agausmann/HWLife/README.md

# HWLife

Experiments in implementing Conway's Game of Life using tiled hardware.
