agausmann/HWLife/(list of files, cad)

Other CAD files:
rev1/life-cell/front-cover/front-cover.scad
rev1/modular-backplane/assembly/backplane-connector-jig.scad
rev1/modular-backplane/backplane-link/common.scad
rev1/modular-backplane/backplane-link/h-link.scad
rev1/modular-backplane/backplane-link/demo.scad
rev1/modular-backplane/backplane-link/x-link.scad
