agausmann/HWLife/rev2/life-cell-rev2/life-cell-rev2.kicad_pcb

## KiCad design rev2/life-cell-rev2/life-cell-rev2.kicad_pcb (2024-03-23, an earlier design)

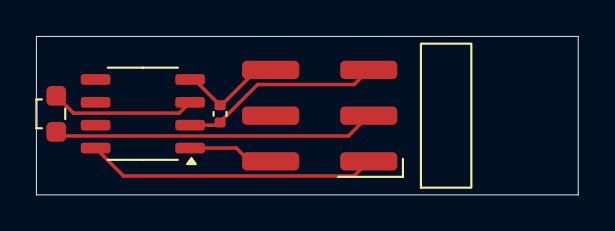
[picture p3: board life-cell-rev2.kicad_pcb from above]

Board: 2 copper layers, 30.1 x 8.8 mm, 4 parts (0 on the bottom side), 6 nets.

Parts:
C1: 100nF; C_0402_1005Metric
D1: LED; LiteOn_LTST-S270KxKT
J1: Backplane; Conn_HCTL_PZ254-2-03-WS
U1: CH32V003J4M6; SOP-8_3.9x4.9mm_P1.27mm

Connections:
/DIM: D1.1 (K), J1.3
/LED: D1.2 (A), U1.3 (PA2)
/RX: J1.2, U1.1 (PD6/PA1)
/TX/SWIO: J1.1, U1.8 (PD1/PD4/PD5)
VDD: C1.1, J1.6, U1.4 (VDD)
VSS: C1.2, J1.5, U1.2 (VSS)
