agausmann/HWLife/rev2/backplane-rev2/backplane-rev2.kicad_pcb

## KiCad design rev2/backplane-rev2/backplane-rev2.kicad_pcb (2024-03-23, an earlier design)

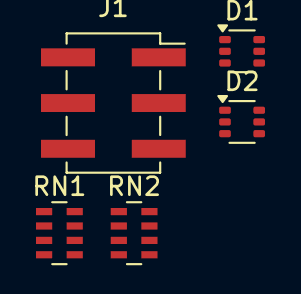
[picture p4: board backplane-rev2.kicad_pcb from above]

Board: 2 copper layers, 5 parts (0 on the bottom side), 9 nets, no tracks yet.

Parts:
D1, D2: BAT54ADW; SOT-363_SC-70-6
J1: Module; PinSocket_2x03_P2.54mm_Vertical_SMD
RN1, RN2: 10K; R_Array_Concave_4x0603

Connections:
/A1/D: D1.3 (A), D1.6 (A), D2.3 (A), D2.6 (A), J1.3
unnamed: D1.1 (K), RN1.5 (R4.2)
unnamed: D1.2 (K), RN1.6 (R3.2)
unnamed: D1.4 (K), RN1.7 (R2.2)
unnamed: D1.5 (K), RN1.8 (R1.2)
unnamed: D2.1 (K), RN2.5 (R4.2)
unnamed: D2.2 (K), RN2.6 (R3.2)
unnamed: D2.4 (K), RN2.7 (R2.2)
unnamed: D2.5 (K), RN2.8 (R1.2)
