agausmann/HWLife/rev1/modular-backplane/single-cell/single-cell.kicad_pcb

## KiCad design rev1/modular-backplane/single-cell/single-cell.kicad_pcb (2023-02-07, an earlier design)

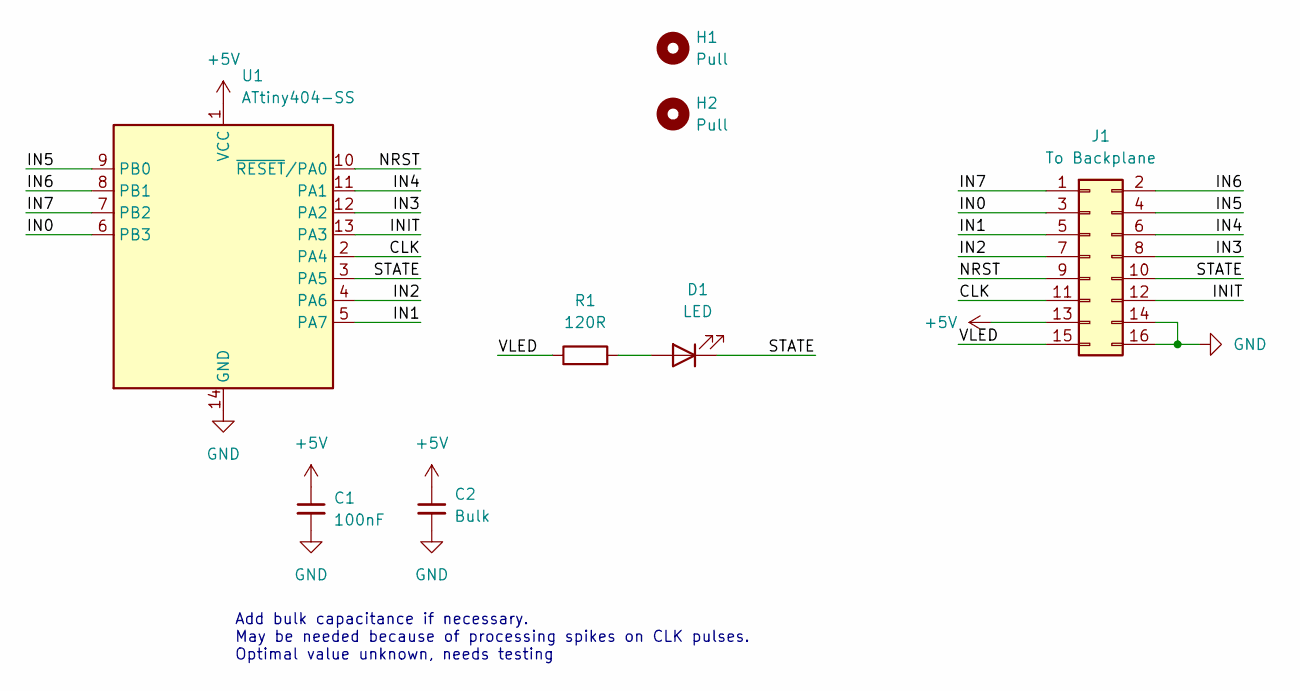
[picture p5: schematic single-cell.kicad_sch]

Parts:
C1: 100nF; C_0603_1608Metric_Pad1.08x0.95mm_HandSolder; DigiKey 2997-MA0603XR104M160TR-ND
C2: Bulk; C_0603_1608Metric_Pad1.08x0.95mm_HandSolder
D1: LED; LED_0603_1608Metric_Pad1.05x0.95mm_HandSolder; DigiKey 3147-B1911UYG-20D000114U1930CT-ND
H1, H2: Pull; Hole_Cell
J1: To Backplane; XKB_X1321FVS_02x08_P1.27mm_Vertical
R1: 120R; R_0603_1608Metric_Pad0.98x0.95mm_HandSolder; DigiKey 2571-RM06F1200CTTR-ND
U1: ATtiny404-SS; SOIC-14_3.9x8.7mm_P1.27mm; DigiKey ATTINY404-SSN-ND

Connections:
+5V: C1.1, C2.1, J1.13, U1.1 (VCC)
/CLK: J1.11, U1.2 (PA4)
/IN0: J1.3, U1.6 (PB3)
/IN1: J1.5, U1.5 (PA7)
/IN2: J1.7, U1.4 (PA6)
/IN3: J1.8, U1.12 (PA2)
/IN4: J1.6, U1.11 (PA1)
/IN5: J1.4, U1.9 (PB0)
/IN6: J1.2, U1.8 (PB1)
/IN7: J1.1, U1.7 (PB2)
/INIT: J1.12, U1.13 (PA3)
/NRST: J1.9, U1.10 (~RESET/PA0)
/STATE: D1.1 (K), J1.10, U1.3 (PA5)
/VLED: J1.15, R1.1
GND: C1.2, C2.2, J1.14, J1.16, U1.14 (GND)
unnamed: D1.2 (A), R1.2

Notes on the sheet:
Add bulk capacitance if necessary. May be needed because of processing spikes on CLK pulses. Optimal value unknown, needs testing

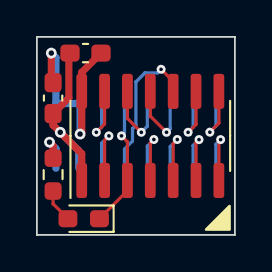
[picture p6: board single-cell.kicad_pcb from above]

Board: 2 copper layers, 11.0 x 11.0 mm, 8 parts (1 on the bottom side), 16 nets.
