agausmann/HWLife/rev1/modular-backplane/backplane/backplane.kicad_pcb

## KiCad design rev1/modular-backplane/backplane/backplane.kicad_pcb (2023-02-07, an earlier design)

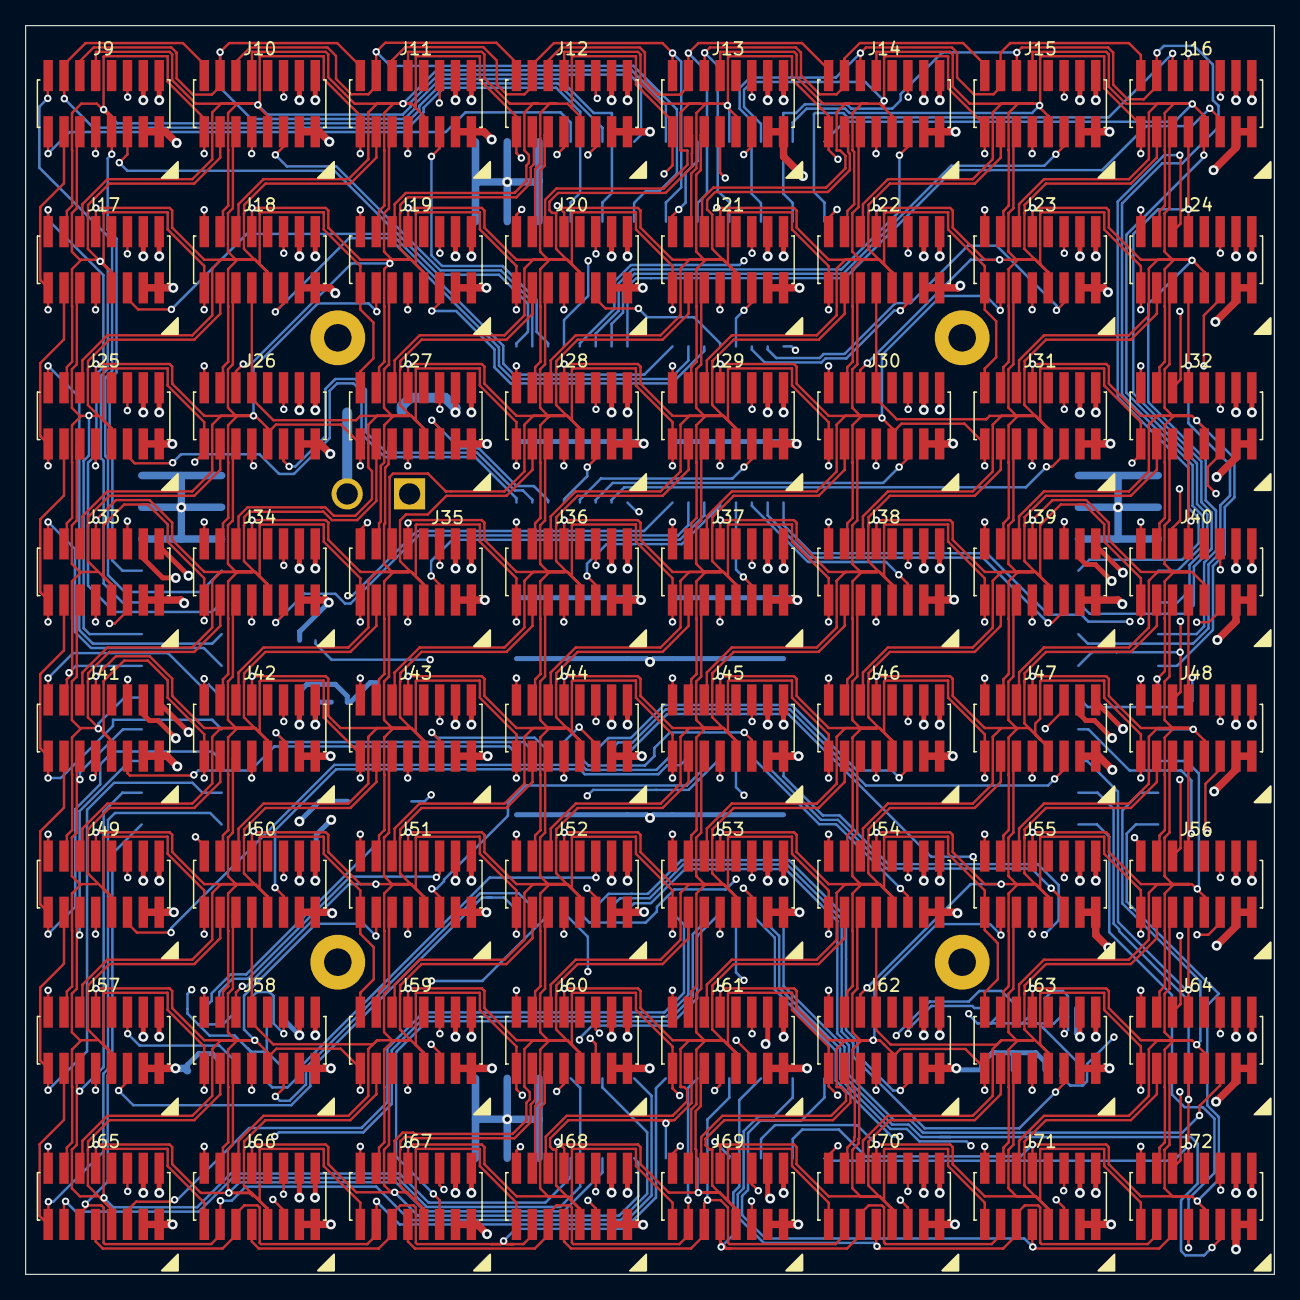
[picture p7: board backplane.kicad_pcb from above]

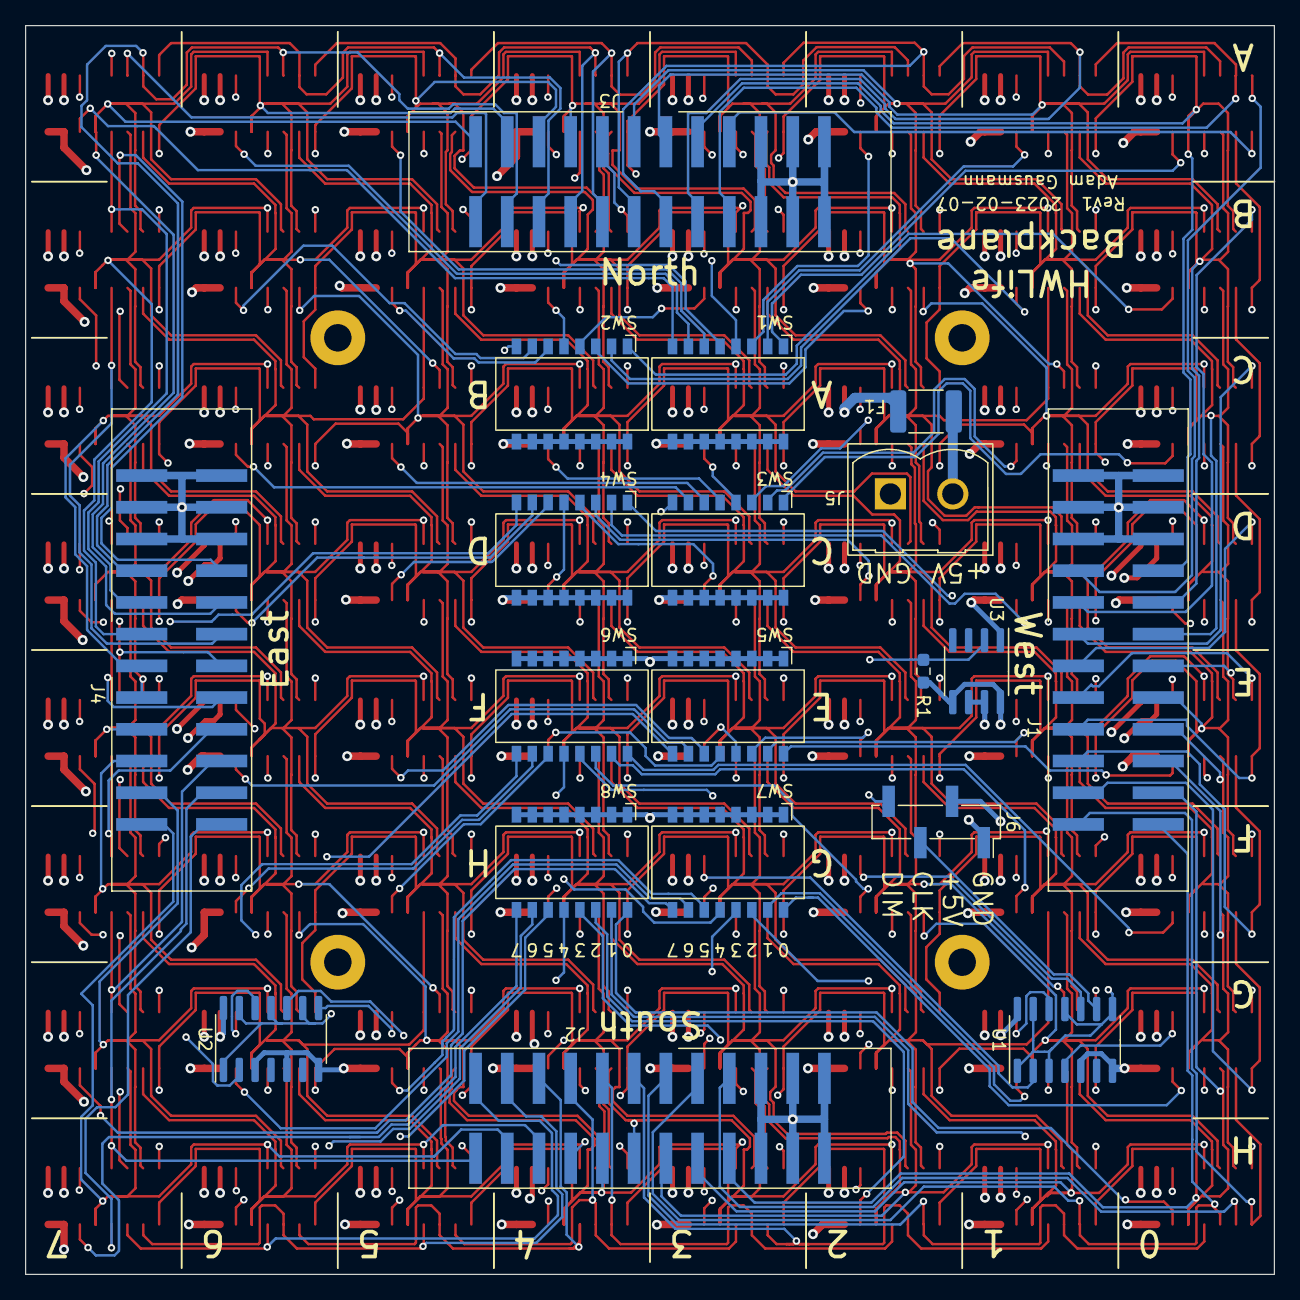
[picture p8: board backplane.kicad_pcb from below]

Board: 4 copper layers, 100.0 x 100.0 mm, 87 parts (19 on the bottom side), 179 nets.

Parts:
F1: 6V 3A; Fuse_1812_4532Metric_Pad1.30x3.40mm_HandSolder
H1, H2, H3, H4: MountingHole; MountingHole_2.2mm_M2_Pad
J1: West; JILN_321024M_02x12_P2.54mm_Vertical
J2: South; JILN_321024M_02x12_P2.54mm_Vertical
J3: North; JILN_321024M_02x12_P2.54mm_Vertical
J4: East; JILN_321024M_02x12_P2.54mm_Vertical
J5: 25-E900-02; Conn_NTE_25-E900-02_01x02_P5.00mm_Vertical
J6: MGMT; PinHeader_1x04_P2.54mm_Vertical_SMD_Pin1Right
J9, J10, J11, J12, J13, J14, J15, J16, J17, J18, J19, J20, J21, J22, J23, J24, J25, J26, J27, J28, J29, J30, J31, J32, J33, J34, J35, J36, J37, J38, J39, J40, J41, J42, J43, J44, J45, J46, J47, J48, J49, J50, J51, J52, J53, J54, J55, J56, J57, J58, J59, J60, J61, J62, J63, J64, J65, J66, J67, J68, J69, J70, J71, J72: Module; DEALON_DZ127S-22-16-55_02x08_P1.27mm_Vertical
R1: 10k; R_0603_1608Metric_Pad0.98x0.95mm_HandSolder
SW1: A; SW_DIP_SPSTx08_Slide_DEALON_SP-08P_P1.27mm
SW2: B; SW_DIP_SPSTx08_Slide_DEALON_SP-08P_P1.27mm
SW3: C; SW_DIP_SPSTx08_Slide_DEALON_SP-08P_P1.27mm
SW4: D; SW_DIP_SPSTx08_Slide_DEALON_SP-08P_P1.27mm
SW5: E; SW_DIP_SPSTx08_Slide_DEALON_SP-08P_P1.27mm
SW6: F; SW_DIP_SPSTx08_Slide_DEALON_SP-08P_P1.27mm
SW7: G; SW_DIP_SPSTx08_Slide_DEALON_SP-08P_P1.27mm
SW8: H; SW_DIP_SPSTx08_Slide_DEALON_SP-08P_P1.27mm
U1, U2: 74HC14; SOIC-14_3.9x8.7mm_P1.27mm
U3: VN5E160S; SOIC-8_3.9x4.9mm_P1.27mm

Connections:
+5V: F1.2, J6.2, J9.13, J10.13, J11.13, J12.13, J13.13, J14.13, J15.13, J16.13, J17.13, J18.13, J19.13, J20.13, J21.13, J22.13, J23.13, J24.13, J25.13, J26.13, J27.13, J28.13, J29.13, J30.13, J31.13, J32.13, J33.13, J34.13, J35.13, J36.13, J37.13, J38.13, J39.13, J40.13, J41.13, J42.13, J43.13, J44.13, J45.13, J46.13, J47.13, J48.13, J49.13, J50.13, J51.13, J52.13, J53.13, J54.13, J55.13, J56.13, J57.13, J58.13, J59.13, J60.13, J61.13, J62.13, J63.13, J64.13, J65.13, J66.13, J67.13, J68.13, J69.13, J70.13, J71.13, J72.13, R1.2, U1.14 (VCC), U2.14 (VCC), U3.5 (VCC), U3.8 (VCC)
/5V_IN: F1.1, J5.2
/CLK0: J9.11, J17.11, J25.11, J33.11, J41.11, J49.11, J57.11, J65.11, U1.4
/CLK1: J10.11, J18.11, J26.11, J34.11, J42.11, J50.11, J58.11, J66.11, U1.12
/CLK2: J11.11, J19.11, J27.11, J35.11, J43.11, J51.11, J59.11, J67.11, U1.10
/CLK3: J12.11, J20.11, J28.11, J36.11, J44.11, J52.11, J60.11, J68.11, U1.2
/CLK4: J13.11, J21.11, J29.11, J37.11, J45.11, J53.11, J61.11, J69.11, U2.10
/CLK5: J14.11, J22.11, J30.11, J38.11, J46.11, J54.11, J62.11, J70.11, U2.8
/CLK6: J15.11, J23.11, J31.11, J39.11, J47.11, J55.11, J63.11, J71.11, U2.12
/CLK7: J16.11, J24.11, J32.11, J40.11, J48.11, J56.11, J64.11, J72.11, U2.2
/Cell-A0/IN0: J3.8, J9.3, J10.1
/Cell-A0/IN1: J3.10, J9.5, J10.3, J11.1
/Cell-A0/IN5: J1.11, J9.4, J17.2, J25.1
/Cell-A0/IN6: J1.9, J3.7, J9.2, J17.1
/Cell-A0/IN7: J1.7, J9.1
/Cell-A0/STATE: J1.8, J3.9, J9.10, J10.2, J17.3, J18.1
/Cell-A1/IN1: J3.12, J10.5, J11.3, J12.1
/Cell-A1/STATE: J3.11, J9.7, J10.10, J11.2, J17.5, J18.3, J19.1
/Cell-A2/IN1: J3.14, J11.5, J12.3, J13.1
/Cell-A2/STATE: J3.13, J10.7, J11.10, J12.2, J18.5, J19.3, J20.1
/Cell-A3/IN1: J3.16, J12.5, J13.3, J14.1
/Cell-A3/STATE: J3.15, J11.7, J12.10, J13.2, J19.5, J20.3, J21.1
/Cell-A4/IN1: J3.18, J13.5, J14.3, J15.1
/Cell-A4/STATE: J3.17, J12.7, J13.10, J14.2, J20.5, J21.3, J22.1
/Cell-A5/IN1: J3.20, J14.5, J15.3, J16.1
/Cell-A5/STATE: J3.19, J13.7, J14.10, J15.2, J21.5, J22.3, J23.1
/Cell-A6/IN1: J3.22, J4.7, J15.5, J16.3
/Cell-A6/STATE: J3.21, J14.7, J15.10, J16.2, J22.5, J23.3, J24.1
/Cell-A7/IN1: J3.24, J16.5
/Cell-A7/IN2: J4.8, J16.7, J24.5
/Cell-A7/IN3: J4.10, J16.8, J24.7, J32.5
/Cell-A7/STATE: J3.23, J4.9, J15.7, J16.10, J23.5, J24.3
/Cell-B0/IN5: J1.13, J17.4, J25.2, J33.1
/Cell-B0/STATE: J1.10, J9.6, J10.4, J17.10, J18.2, J25.3, J26.1
/Cell-B1/STATE: J9.8, J10.6, J11.4, J17.7, J18.10, J19.2, J25.5, J26.3, J27.1
/Cell-B2/STATE: J10.8, J11.6, J12.4, J18.7, J19.10, J20.2, J26.5, J27.3, J28.1
/Cell-B3/STATE: J11.8, J12.6, J13.4, J19.7, J20.10, J21.2, J27.5, J28.3, J29.1
/Cell-B4/STATE: J12.8, J13.6, J14.4, J20.7, J21.10, J22.2, J28.5, J29.3, J30.1
/Cell-B5/STATE: J13.8, J14.6, J15.4, J21.7, J22.10, J23.2, J29.5, J30.3, J31.1
/Cell-B6/STATE: J14.8, J15.6, J16.4, J22.7, J23.10, J24.2, J30.5, J31.3, J32.1
/Cell-B7/IN3: J4.12, J24.8, J32.7, J40.5
/Cell-B7/STATE: J4.11, J15.8, J16.6, J23.7, J24.10, J31.5, J32.3
/Cell-C0/IN5: J1.15, J25.4, J33.2, J41.1
/Cell-C0/STATE: J1.12, J17.6, J18.4, J25.10, J26.2, J33.3, J34.1
/Cell-C1/STATE: J17.8, J18.6, J19.4, J25.7, J26.10, J27.2, J33.5, J34.3, J35.1
/Cell-C2/STATE: J18.8, J19.6, J20.4, J26.7, J27.10, J28.2, J34.5, J35.3, J36.1
/Cell-C3/STATE: J19.8, J20.6, J21.4, J27.7, J28.10, J29.2, J35.5, J36.3, J37.1
/Cell-C4/STATE: J20.8, J21.6, J22.4, J28.7, J29.10, J30.2, J36.5, J37.3, J38.1
/Cell-C5/STATE: J21.8, J22.6, J23.4, J29.7, J30.10, J31.2, J37.5, J38.3, J39.1
/Cell-C6/STATE: J22.8, J23.6, J24.4, J30.7, J31.10, J32.2, J38.5, J39.3, J40.1
/Cell-C7/IN3: J4.14, J32.8, J40.7, J48.5
/Cell-C7/STATE: J4.13, J23.8, J24.6, J31.7, J32.10, J39.5, J40.3
/Cell-D0/IN5: J1.17, J33.4, J41.2, J49.1
/Cell-D0/STATE: J1.14, J25.6, J26.4, J33.10, J34.2, J41.3, J42.1
/Cell-D1/STATE: J25.8, J26.6, J27.4, J33.7, J34.10, J35.2, J41.5, J42.3, J43.1
/Cell-D2/STATE: J26.8, J27.6, J28.4, J34.7, J35.10, J36.2, J42.5, J43.3, J44.1
/Cell-D3/STATE: J27.8, J28.6, J29.4, J35.7, J36.10, J37.2, J43.5, J44.3, J45.1
/Cell-D4/STATE: J28.8, J29.6, J30.4, J36.7, J37.10, J38.2, J44.5, J45.3, J46.1
/Cell-D5/STATE: J29.8, J30.6, J31.4, J37.7, J38.10, J39.2, J45.5, J46.3, J47.1
/Cell-D6/STATE: J30.8, J31.6, J32.4, J38.7, J39.10, J40.2, J46.5, J47.3, J48.1
/Cell-D7/IN3: J4.16, J40.8, J48.7, J56.5
/Cell-D7/STATE: J4.15, J31.8, J32.6, J39.7, J40.10, J47.5, J48.3
/Cell-E0/IN5: J1.19, J41.4, J49.2, J57.1
/Cell-E0/STATE: J1.16, J33.6, J34.4, J41.10, J42.2, J49.3, J50.1
/Cell-E1/STATE: J33.8, J34.6, J35.4, J41.7, J42.10, J43.2, J49.5, J50.3, J51.1
/Cell-E2/STATE: J34.8, J35.6, J36.4, J42.7, J43.10, J44.2, J50.5, J51.3, J52.1
/Cell-E3/STATE: J35.8, J36.6, J37.4, J43.7, J44.10, J45.2, J51.5, J52.3, J53.1
/Cell-E4/STATE: J36.8, J37.6, J38.4, J44.7, J45.10, J46.2, J52.5, J53.3, J54.1
/Cell-E5/STATE: J37.8, J38.6, J39.4, J45.7, J46.10, J47.2, J53.5, J54.3, J55.1
/Cell-E6/STATE: J38.8, J39.6, J40.4, J46.7, J47.10, J48.2, J54.5, J55.3, J56.1
/Cell-E7/IN3: J4.18, J48.8, J56.7, J64.5
/Cell-E7/STATE: J4.17, J39.8, J40.6, J47.7, J48.10, J55.5, J56.3
/Cell-F0/IN5: J1.21, J49.4, J57.2, J65.1
/Cell-F0/STATE: J1.18, J41.6, J42.4, J49.10, J50.2, J57.3, J58.1
/Cell-F1/STATE: J41.8, J42.6, J43.4, J49.7, J50.10, J51.2, J57.5, J58.3, J59.1
/Cell-F2/STATE: J42.8, J43.6, J44.4, J50.7, J51.10, J52.2, J58.5, J59.3, J60.1
/Cell-F3/STATE: J43.8, J44.6, J45.4, J51.7, J52.10, J53.2, J59.5, J60.3, J61.1
/Cell-F4/STATE: J44.8, J45.6, J46.4, J52.7, J53.10, J54.2, J60.5, J61.3, J62.1
/Cell-F5/STATE: J45.8, J46.6, J47.4, J53.7, J54.10, J55.2, J61.5, J62.3, J63.1
/Cell-F6/STATE: J46.8, J47.6, J48.4, J54.7, J55.10, J56.2, J62.5, J63.3, J64.1
/Cell-F7/IN3: J4.20, J56.8, J64.7, J72.5
/Cell-F7/STATE: J4.19, J47.8, J48.6, J55.7, J56.10, J63.5, J64.3
/Cell-G0/IN5: J1.23, J57.4, J65.2
/Cell-G0/STATE: J1.20, J49.6, J50.4, J57.10, J58.2, J65.3, J66.1
/Cell-G1/STATE: J49.8, J50.6, J51.4, J57.7, J58.10, J59.2, J65.5, J66.3, J67.1
/Cell-G2/STATE: J50.8, J51.6, J52.4, J58.7, J59.10, J60.2, J66.5, J67.3, J68.1
/Cell-G3/STATE: J51.8, J52.6, J53.4, J59.7, J60.10, J61.2, J67.5, J68.3, J69.1
/Cell-G4/STATE: J52.8, J53.6, J54.4, J60.7, J61.10, J62.2, J68.5, J69.3, J70.1
/Cell-G5/STATE: J53.8, J54.6, J55.4, J61.7, J62.10, J63.2, J69.5, J70.3, J71.1
/Cell-G6/STATE: J54.8, J55.6, J56.4, J62.7, J63.10, J64.2, J70.5, J71.3, J72.1
/Cell-G7/IN3: J2.24, J4.22, J64.8, J72.7
/Cell-G7/STATE: J4.21, J55.8, J56.6, J63.7, J64.10, J71.5, J72.3
/Cell-H0/IN3: J2.11, J65.8, J66.6, J67.4
/Cell-H0/IN4: J1.24, J2.9, J65.6, J66.4
/Cell-H0/IN5: J2.7, J65.4
/Cell-H0/STATE: J1.22, J2.8, J57.6, J58.4, J65.10, J66.2
/Cell-H1/IN3: J2.13, J66.8, J67.6, J68.4
/Cell-H1/STATE: J2.10, J57.8, J58.6, J59.4, J65.7, J66.10, J67.2
/Cell-H2/IN3: J2.15, J67.8, J68.6, J69.4
/Cell-H2/STATE: J2.12, J58.8, J59.6, J60.4, J66.7, J67.10, J68.2
/Cell-H3/IN3: J2.17, J68.8, J69.6, J70.4
/Cell-H3/STATE: J2.14, J59.8, J60.6, J61.4, J67.7, J68.10, J69.2
/Cell-H4/IN3: J2.19, J69.8, J70.6, J71.4
/Cell-H4/STATE: J2.16, J60.8, J61.6, J62.4, J68.7, J69.10, J70.2
/Cell-H5/IN3: J2.21, J70.8, J71.6, J72.4
/Cell-H5/STATE: J2.18, J61.8, J62.6, J63.4, J69.7, J70.10, J71.2
/Cell-H6/IN3: J2.23, J71.8, J72.6
/Cell-H6/STATE: J2.20, J62.8, J63.6, J64.4, J70.7, J71.10, J72.2
/Cell-H7/IN3: J4.24, J72.8
/Cell-H7/STATE: J2.22, J4.23, J63.8, J64.6, J71.7, J72.10
/T-A0: J9.12, SW1.1
/T-A1: J10.12, SW1.2
/T-A2: J11.12, SW1.3
/T-A3: J12.12, SW1.4
/T-A4: J13.12, SW1.5
/T-A5: J14.12, SW1.6
/T-A6: J15.12, SW1.7
/T-A7: J16.12, SW1.8
/T-B0: J17.12, SW2.1
/T-B1: J18.12, SW2.2
/T-B2: J19.12, SW2.3
/T-B3: J20.12, SW2.4
/T-B4: J21.12, SW2.5
/T-B5: J22.12, SW2.6
/T-B6: J23.12, SW2.7
/T-B7: J24.12, SW2.8
/T-C0: J25.12, SW3.1
/T-C1: J26.12, SW3.2
/T-C2: J27.12, SW3.3
/T-C3: J28.12, SW3.4
/T-C4: J29.12, SW3.5
/T-C5: J30.12, SW3.6
/T-C6: J31.12, SW3.7
/T-C7: J32.12, SW3.8
/T-D0: J33.12, SW4.1
/T-D1: J34.12, SW4.2
/T-D2: J35.12, SW4.3
/T-D3: J36.12, SW4.4
/T-D4: J37.12, SW4.5
/T-D5: J38.12, SW4.6
/T-D6: J39.12, SW4.7
/T-D7: J40.12, SW4.8
/T-E0: J41.12, SW5.16
/T-E1: J42.12, SW5.15
/T-E2: J43.12, SW5.14
/T-E3: J44.12, SW5.13
/T-E4: J45.12, SW5.12
/T-E5: J46.12, SW5.11
/T-E6: J47.12, SW5.10
/T-E7: J48.12, SW5.9
/T-F0: J49.12, SW6.16
/T-F1: J50.12, SW6.15
/T-F2: J51.12, SW6.14
/T-F3: J52.12, SW6.13
/T-F4: J53.12, SW6.12
/T-F5: J54.12, SW6.11
/T-F6: J55.12, SW6.10
/T-F7: J56.12, SW6.9
/T-G0: J57.12, SW7.16
/T-G1: J58.12, SW7.15
/T-G2: J59.12, SW7.14
/T-G3: J60.12, SW7.13
/T-G4: J61.12, SW7.12
/T-G5: J62.12, SW7.11
/T-G6: J63.12, SW7.10
/T-G7: J64.12, SW7.9
/T-H0: J65.12, SW8.16
/T-H1: J66.12, SW8.15
/T-H2: J67.12, SW8.14
/T-H3: J68.12, SW8.13
/T-H4: J69.12, SW8.12
/T-H5: J70.12, SW8.11
/T-H6: J71.12, SW8.10
/T-H7: J72.12, SW8.9
CLK: J6.3, U1.9
DIM: J6.4, R1.1, U3.2 (INPUT)
GND: J1.1, J1.2, J1.3, J1.4, J1.5, J1.6, J2.1, J2.2, J2.3, J2.4, J2.5, J2.6, J3.1, J3.2, J3.3, J3.4, J3.5, J3.6, J4.1, J4.2, J4.3, J4.4, J4.5, J4.6, J5.1, J6.1, J9.14, J9.16, J10.14, J10.16, J11.14, J11.16, J12.14, J12.16, J13.14, J13.16, J14.14, J14.16, J15.14, J15.16, J16.14, J16.16, J17.14, J17.16, J18.14, J18.16, J19.14, J19.16, J20.14, J20.16, J21.14, J21.16, J22.14, J22.16, J23.14, J23.16, J24.14, J24.16, J25.14, J25.16, J26.14, J26.16, J27.14, J27.16, J28.14, J28.16, J29.14, J29.16, J30.14, J30.16, J31.14, J31.16, J32.14, J32.16, J33.14, J33.16, J34.14, J34.16, J35.14, J35.16, J36.14, J36.16, J37.14, J37.16, J38.14, J38.16, J39.14, J39.16, J40.14, J40.16, J41.14, J41.16, J42.14, J42.16, J43.14, J43.16, J44.14, J44.16, J45.14, J45.16, J46.14, J46.16, J47.14, J47.16, J48.14, J48.16, J49.14, J49.16, J50.14, J50.16, J51.14, J51.16, J52.14, J52.16, J53.14, J53.16, J54.14, J54.16, J55.14, J55.16, J56.14, J56.16, J57.14, J57.16, J58.14, J58.16, J59.14, J59.16, J60.14, J60.16, J61.14, J61.16, J62.14, J62.16, J63.14, J63.16, J64.14, J64.16, J65.14, J65.16, J66.14, J66.16, J67.14, J67.16, J68.14, J68.16, J69.14, J69.16, J70.14, J70.16, J71.14, J71.16, J72.14, J72.16, SW1.9, SW1.10, SW1.11, SW1.12, SW1.13, SW1.14, SW1.15, SW1.16, SW2.9, SW2.10, SW2.11, SW2.12, SW2.13, SW2.14, SW2.15, SW2.16, SW3.9, SW3.10, SW3.11, SW3.12, SW3.13, SW3.14, SW3.15, SW3.16, SW4.9, SW4.10, SW4.11, SW4.12, SW4.13, SW4.14, SW4.15, SW4.16, SW5.1, SW5.2, SW5.3, SW5.4, SW5.5, SW5.6, SW5.7, SW5.8, SW6.1, SW6.2, SW6.3, SW6.4, SW6.5, SW6.6, SW6.7, SW6.8, SW7.1, SW7.2, SW7.3, SW7.4, SW7.5, SW7.6, SW7.7, SW7.8, SW8.1, SW8.2, SW8.3, SW8.4, SW8.5, SW8.6, SW8.7, SW8.8, U1.5, U1.7 (GND), U2.3, U2.5, U2.7 (GND), U3.1 (GND)
unnamed: U1.1, U1.3, U1.8, U1.11, U1.13, U2.1, U2.9, U2.11, U2.13
VLED: J9.15, J10.15, J11.15, J12.15, J13.15, J14.15, J15.15, J16.15, J17.15, J18.15, J19.15, J20.15, J21.15, J22.15, J23.15, J24.15, J25.15, J26.15, J27.15, J28.15, J29.15, J30.15, J31.15, J32.15, J33.15, J34.15, J35.15, J36.15, J37.15, J38.15, J39.15, J40.15, J41.15, J42.15, J43.15, J44.15, J45.15, J46.15, J47.15, J48.15, J49.15, J50.15, J51.15, J52.15, J53.15, J54.15, J55.15, J56.15, J57.15, J58.15, J59.15, J60.15, J61.15, J62.15, J63.15, J64.15, J65.15, J66.15, J67.15, J68.15, J69.15, J70.15, J71.15, J72.15, U3.6 (OUTPUT), U3.7 (OUTPUT)
