agausmann/HWLife/rev1/life-cell/pcb/life-cell.kicad_pcb

## KiCad design rev1/life-cell/pcb/life-cell.kicad_pcb (2023-01-13, an earlier design)

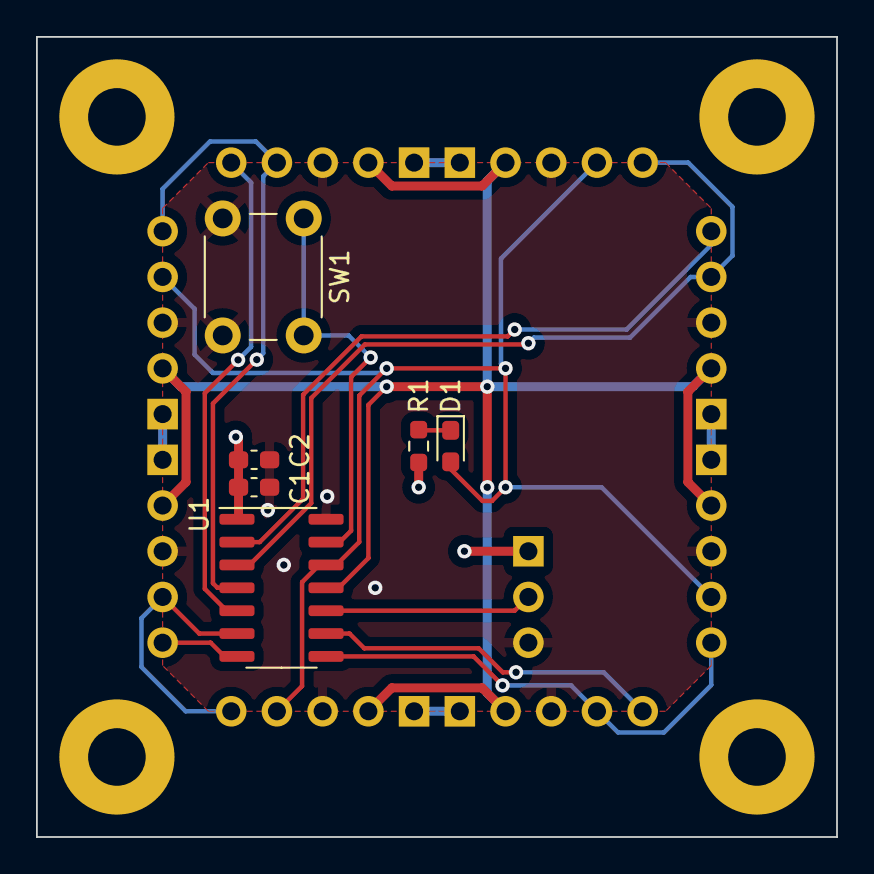
[picture p9: board life-cell.kicad_pcb from above]

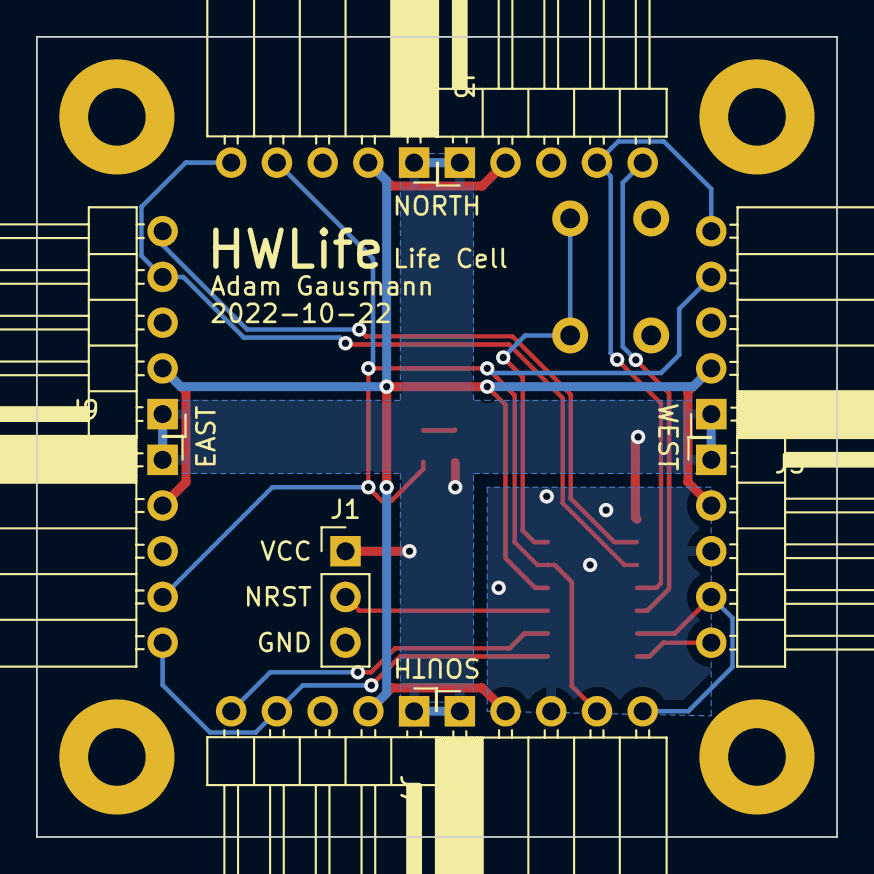
[picture p10: board life-cell.kicad_pcb from below]

Board: 2 copper layers, 44.4 x 44.4 mm, 19 parts (9 on the bottom side), 15 nets.

Parts:
C1: 100nF; C_0603_1608Metric_Pad1.08x0.95mm_HandSolder
C2: Bulk; C_0603_1608Metric_Pad1.08x0.95mm_HandSolder
D1: LED; LED_0603_1608Metric_Pad1.05x0.95mm_HandSolder
H1, H2, H3, H4: M3; MountingHole_3.2mm_M3_Pad
J1: UPDI; PinHeader_1x03_P2.54mm_Vertical
J2, J4, J6, J8: Interconnect In; PinHeader_1x05_P2.54mm_Horizontal
J3, J5, J7, J9: Interconnect Out; PinSocket_1x05_P2.54mm_Horizontal
R1: 120R; R_0603_1608Metric_Pad0.98x0.95mm_HandSolder
SW1: Toggle; SW_PUSH_6mm_H4.3mm
U1: ATtiny404-SS; SOIC-14_3.9x8.7mm_P1.27mm

Connections:
/Cell/ADJ1: J2.4, J5.5, U1.4 (PA6)
/Cell/ADJ2: J3.5, J8.4, U1.3 (PA5)
/Cell/ADJ3: J6.4, J9.5, U1.8 (PB1)
/Cell/ADJ4: J4.4, J7.5, U1.6 (PB3)
/Cell/CLK: J2.2, J3.2, J4.2, J5.2, J6.2, J7.2, J8.2, J9.2, U1.11 (PA1)
/Cell/DIA1: J2.5, U1.5 (PA7)
/Cell/DIA2: J8.5, U1.2 (PA4)
/Cell/DIA3: J6.5, U1.9 (PB0)
/Cell/DIA4: J4.5, U1.7 (PB2)
/Cell/NRST: J1.2, U1.10 (~RESET/PA0)
/Cell/STATE: D1.2 (A), J3.4, J5.4, J7.4, J9.4, U1.12 (PA2)
/Cell/TOGGLE: SW1.1, U1.13 (PA3)
GND: C1.2, C2.2, J1.3, J2.3, J3.3, J4.3, J5.3, J6.3, J7.3, J8.3, J9.3, SW1.2, U1.14 (GND)
unnamed: D1.1 (K), R1.2
VCC: C1.1, C2.1, J1.1, J2.1, J3.1, J4.1, J5.1, J6.1, J7.1, J8.1, J9.1, R1.1, U1.1 (VCC)
