agausmann/HWLife/(commit log)

2022-10-23 Initial commit with prototype Life Cell design
    [Cell.kicad_sch, Interconnect.kicad_sch, life-cell.kicad_pcb, life-cell.kicad_sch]
2022-10-24 Fix connector models, add renders and README
    [life-cell.kicad_pcb]
2022-10-24 Fix LED resistor value
    [Cell.kicad_sch, life-cell.kicad_pcb, life-cell.kicad_sch]
2022-10-25 life-cell: Move PCB design files to a subdirectory
    [Cell.kicad_sch, Interconnect.kicad_sch, life-cell.kicad_pcb, life-cell.kicad_sch]
2022-10-25 Add note about avr-device patch
2022-10-26 Add design files for diffuse front cover
    [front-cover.scad]
2022-10-27 Add NSEW schem/silkscreen labels
    [life-cell.kicad_pcb, life-cell.kicad_sch]
2023-01-07 life-cell: Change to sharp corners
    [life-cell.kicad_pcb]
2023-01-13 Switch to "symmetric" connector layout.
    Each side has half male pins and half female pins, for a truly
    symmetric experience!
    [Cell.kicad_sch, Interconnect.kicad_sch, life-cell.kicad_pcb, life-cell.kicad_sch]
2023-01-19 Modular backplane initial design
    I should have committed several times earlier, but better late than
    never.
    New design concept: Individual cells are pluggable modules, and a
    tileable backplane board provides interconnect, power, and clock.
    Current status: Pretty much everything is designed;
    almost everything is routed.
    Some things left to place and route:
    - Power and management connectors
    - DIP switches to set initial state
    - Inverters for clock distribution
    - LED dimmer switch
    [Cell.kicad_sch, backplane.kicad_pcb, backplane.kicad_sch, single-cell.kicad_pcb, single-cell.kicad_sch]
2023-01-19 Update some component details
    [Cell.kicad_sch, backplane.kicad_sch, single-cell.kicad_sch]
2023-01-20 Add more part details
    [backplane.kicad_sch]
2023-01-20 Place and route DIP switches
    [backplane.kicad_pcb, backplane.kicad_sch]
2023-01-21 Place and route power/management connectors and power switch
    [Cell.kicad_sch, backplane.kicad_pcb, backplane.kicad_sch]
2023-01-22 Place and route clock tree; remove NRST from management header
    [Cell.kicad_sch, backplane.kicad_pcb, backplane.kicad_sch]
2023-01-23 Backplane finishing touches
    [backplane.kicad_pcb, backplane.kicad_sch]
2023-02-07 Add PTC fuse; add orientation marks for modules
    [backplane.kicad_pcb, backplane.kicad_sch]
2023-02-07 (Re)route single-cell module; add grabbing holes and markings
    [single-cell.kicad_pcb, single-cell.kicad_sch]
2024-03-04 Move to rev1 subdir
    [Cell.kicad_sch, Interconnect.kicad_sch, backplane.kicad_pcb, backplane.kicad_sch, front-cover.scad, life-cell.kicad_pcb, life-cell.kicad_sch, single-cell.kicad_pcb]
2024-03-23 rev1 misc 3d models
    [backplane-connector-jig.scad, common.scad, demo.scad, h-link.scad, x-link.scad]
2024-03-23 rev2 archive
    [backplane-rev2.kicad_pcb, backplane-rev2.kicad_sch, cell.kicad_sch, life-cell-rev2.kicad_pcb, life-cell-rev2.kicad_sch, neighbor.kicad_sch, quad_cell.kicad_sch]
2024-03-25 Set up timers; PWM demo
2024-03-26 DMA-driven duty cycle demo
2024-03-27 Refactor for DMA interrupts, add data encoder
